zaphoxx/zuhf-rfid/images/cc1101_868MHz_module.jpg

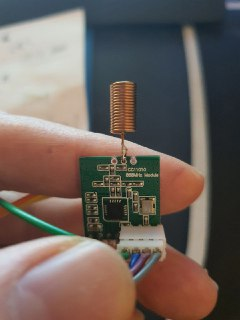
images/cc1101_868MHz_module.jpg
