zaphoxx/zuhf-rfid/images/lock_cmd.png

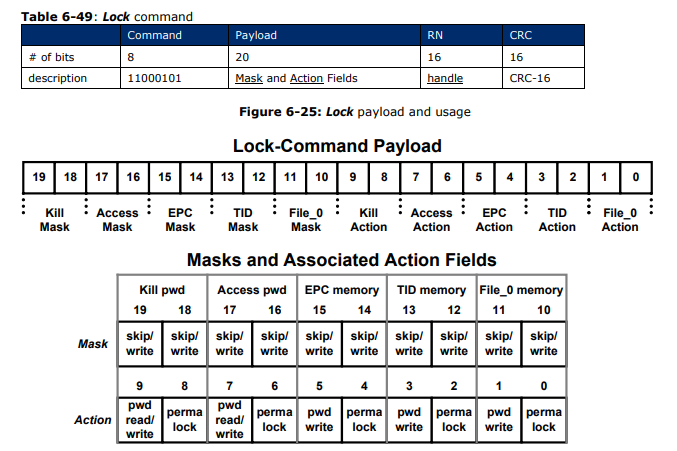
images/lock_cmd.png
