zaphoxx/zuhf-rfid/images/signal from chafon reader.png

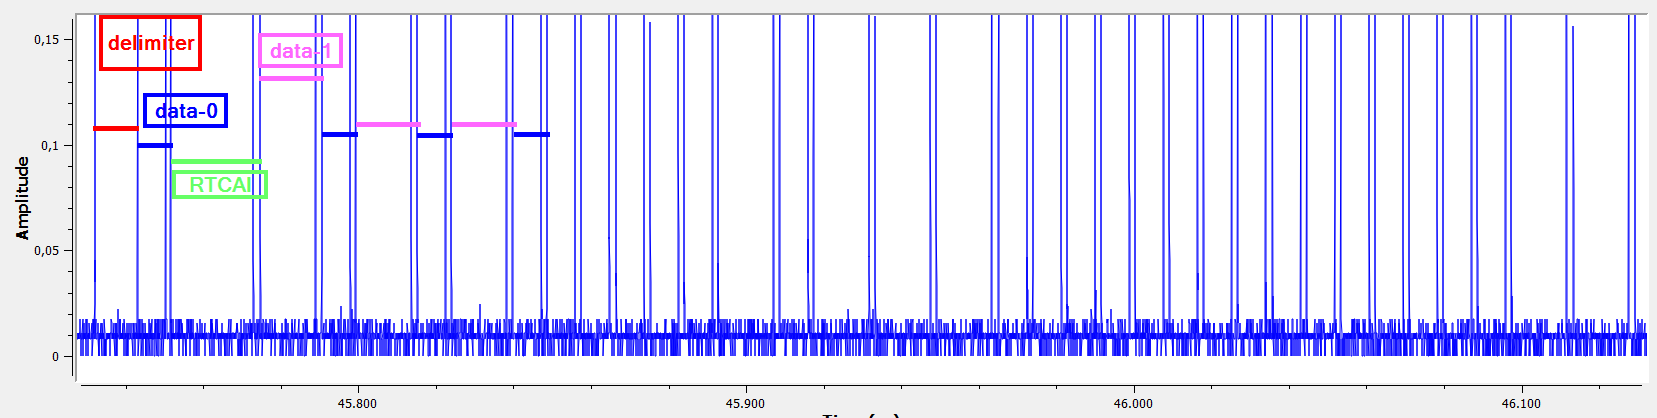
images/signal from chafon reader.png
