zaphoxx/zuhf-rfid/images/tears_001.png

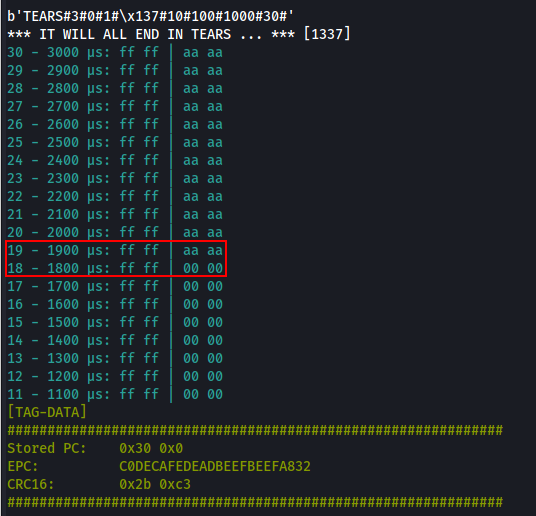
images/tears_001.png
