zaphoxx/zuhf-rfid/images/tears_002.png

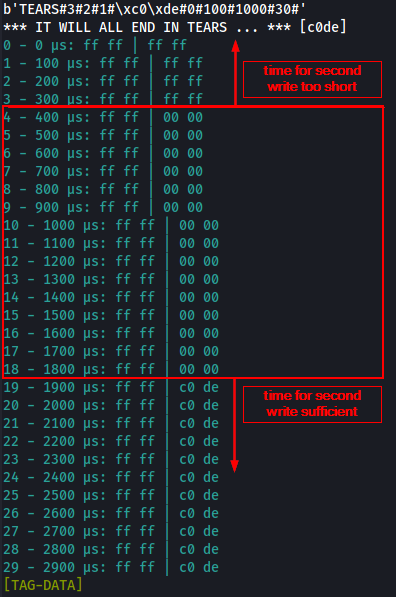
images/tears_002.png
