zaphoxx/zuhf-rfid/images/connections_tx_image.jpg

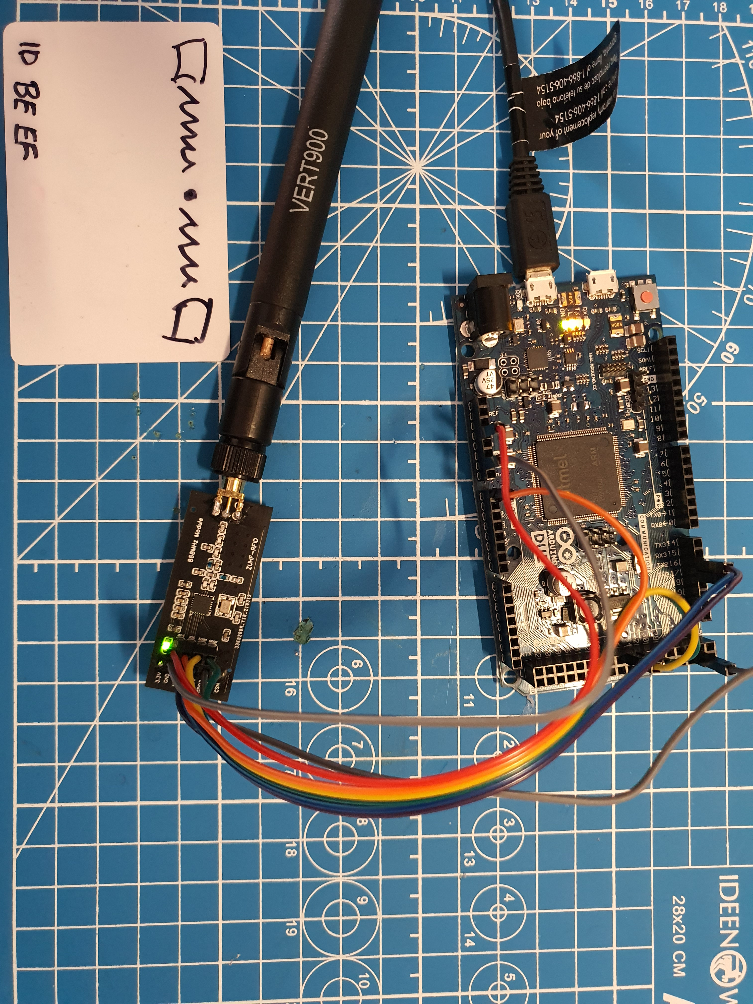
[picture p24: images/connections_tx_image.jpg]
images/connections_tx_image.jpg
